Mandamientos/Cerrojo-CE1107/bitacora/img/decodificador-proteus.png

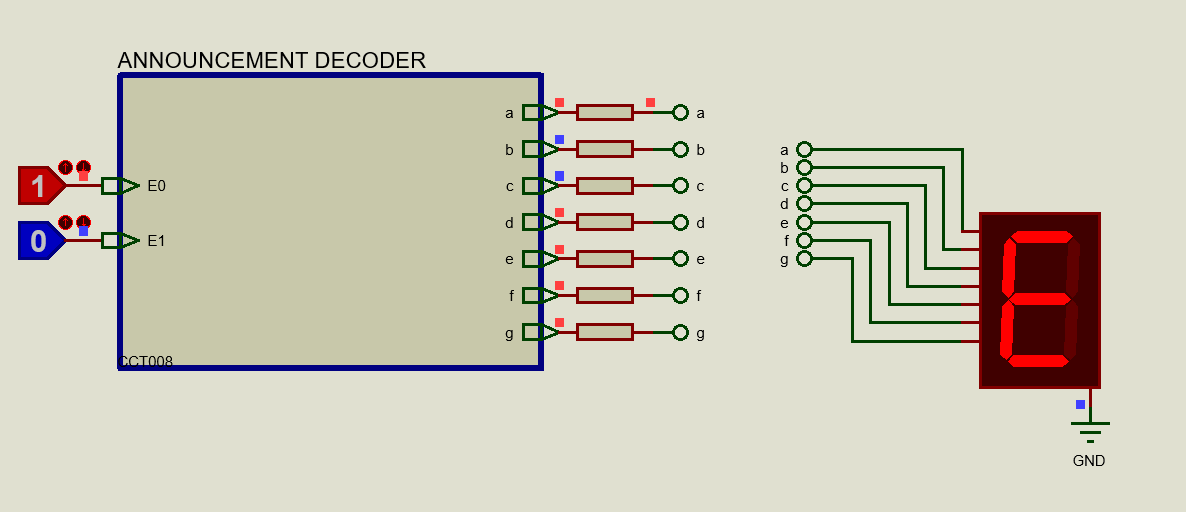
bitacora/img/decodificador-proteus.png
