Mandamientos/Cerrojo-CE1107/(list of files, drawings)

Other design files:
bitacora/Cerrojo.pdsprj
