Mandamientos/Cerrojo-CE1107/(commit log)

2026-09-07 Agregado: portada y entrada del 7 de setiembre (codificador de señas)
2026-09-11 Agregado: verificador de senas y bloque de reloj
2026-09-15 Agregado: State controller y el decodificador de estados.
2026-09-29 Agregado: Comparador, link al repositorio y referencias bibliográficas
    [Cerrojo.pdsprj]
